ptech8000/vitals-wearable/images/photo_2026-11-06_05-55-03.jpg

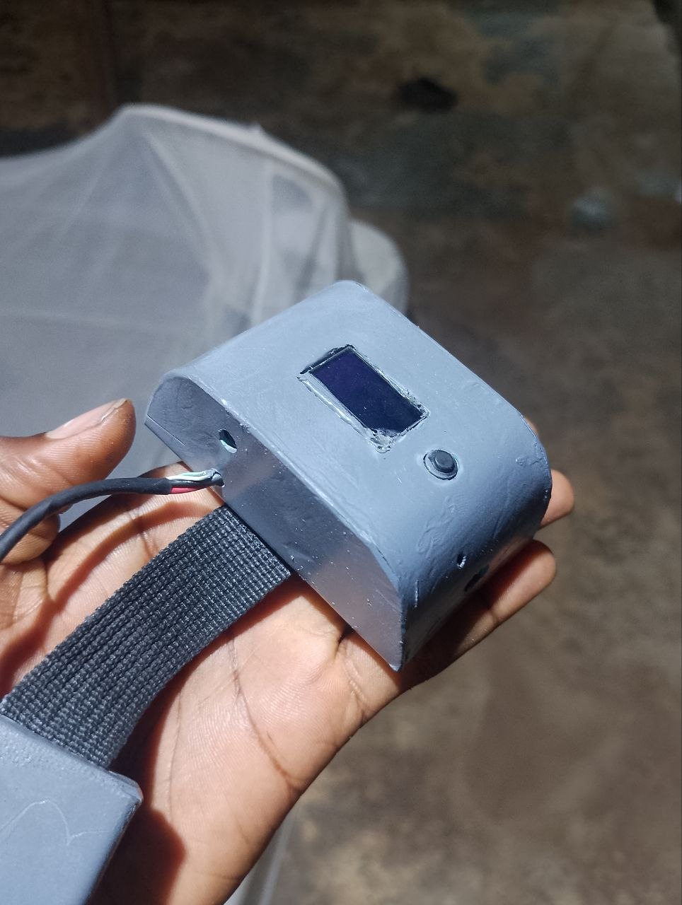
images/photo_2026-11-06_05-55-03.jpg
