ptech8000/vitals-wearable/images/photo_2026-11-06_05-55-32.jpg

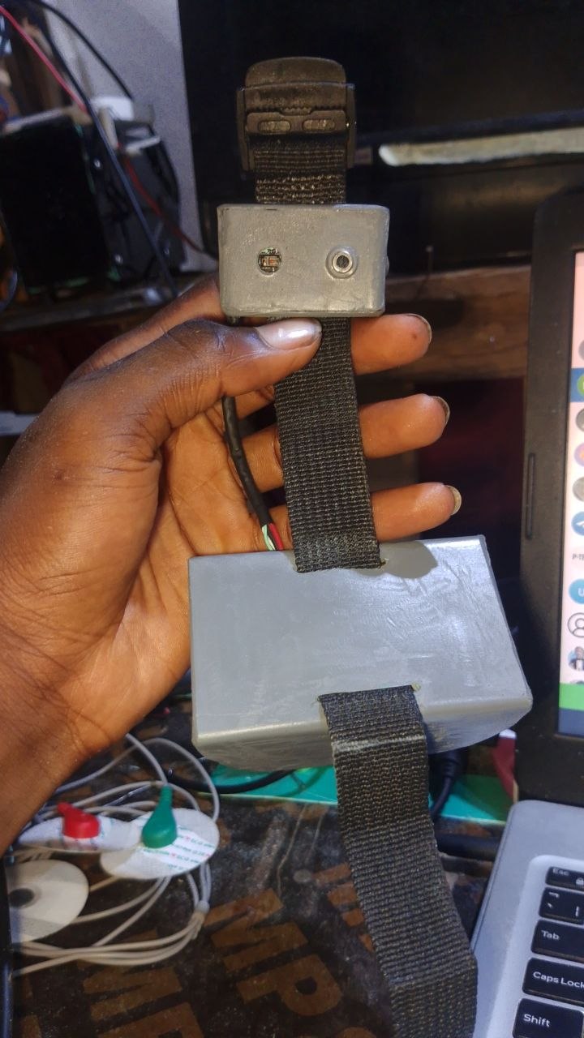
images/photo_2026-11-06_05-55-32.jpg
