ptech8000/vitals-wearable/images/photo_2026-11-06_06-06-29.jpg

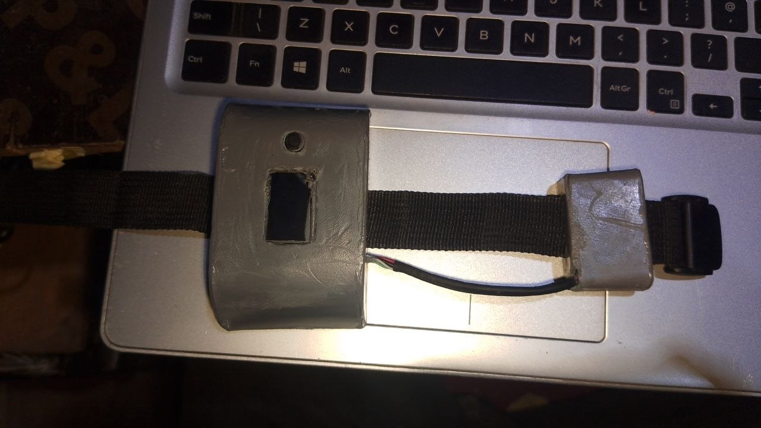
images/photo_2026-11-06_06-06-29.jpg
