ptech8000/vitals-wearable/images/photo_2026-11-06_06-06-43.jpg

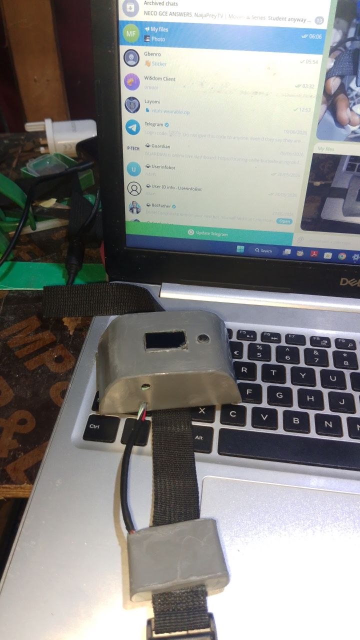
images/photo_2026-11-06_06-06-43.jpg
