ptech8000/vitals-wearable/images/photo_2026-11-06_06-29-23.jpg

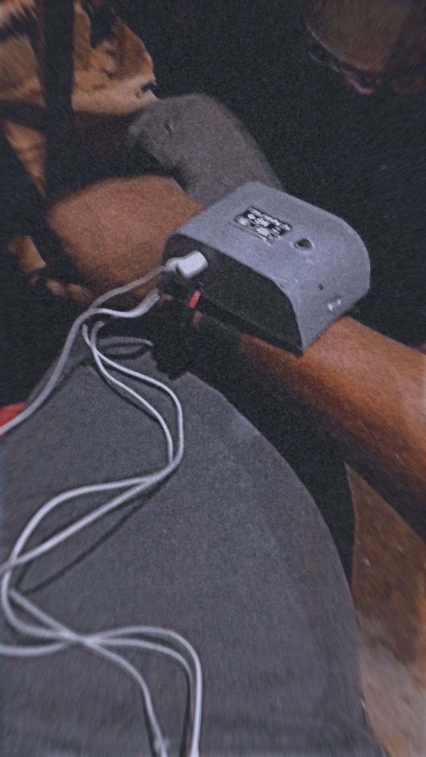
images/photo_2026-11-06_06-29-23.jpg
