ptech8000/vitals-wearable/images/photo_2026-11-06_06-33-55.jpg

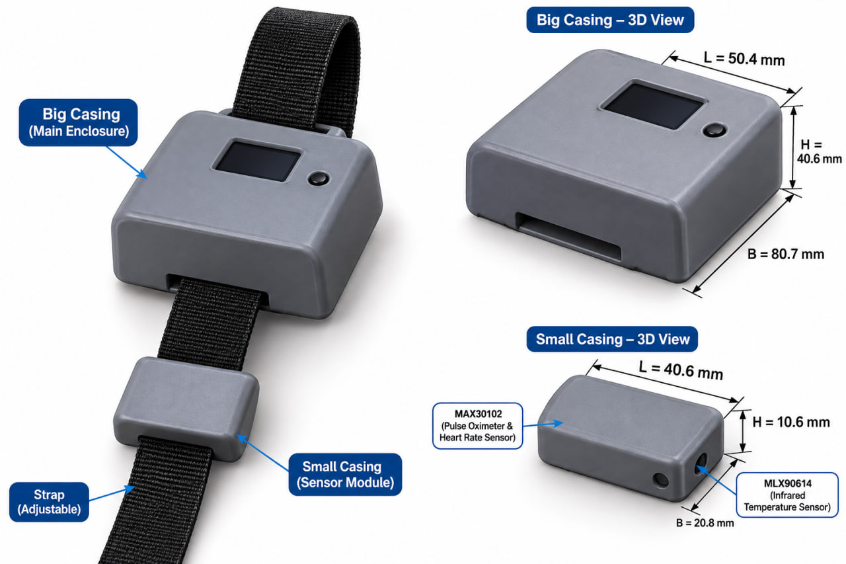
images/photo_2026-11-06_06-33-55.jpg
