ptech8000/vitals-wearable/(commit log)

2026-11-06 Initial commit: ESP32-S3 Smartwatch firmware with OTA, BLE, Wi-Fi, PulseGuard web app, and Flutter client app
2026-11-06 Add Cirkit Designer circuit schematic diagram
2026-11-06 Embed Cirkit Designer schematic diagram in README
