ptech8000/vitals-wearable/(notices)

Notices in the files:
README.md:
License: MIT
